VedantSheel08/SmartSolarTracker/FLOW CHART Smart Solar Panel.pdf

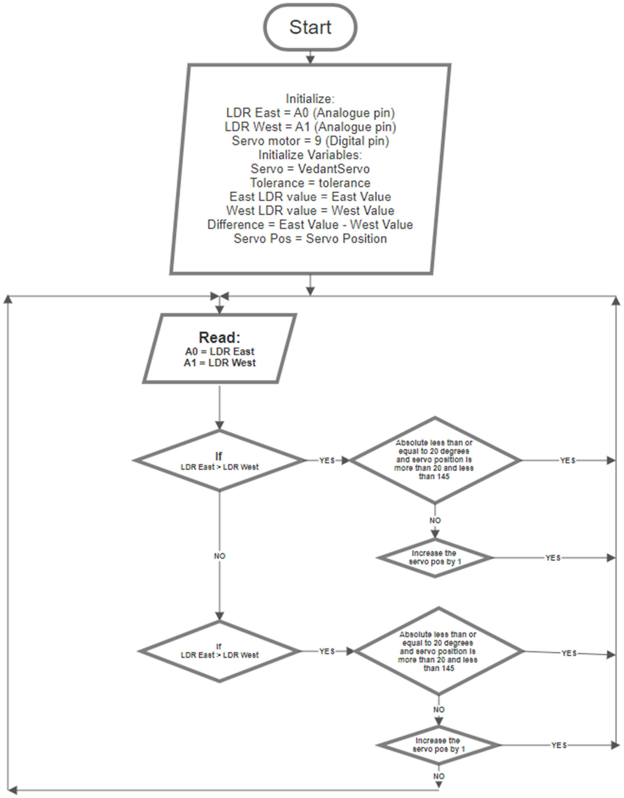
[picture p2: page 1]
