VedantSheel08/SmartSolarTracker/Arduino circut.jpg

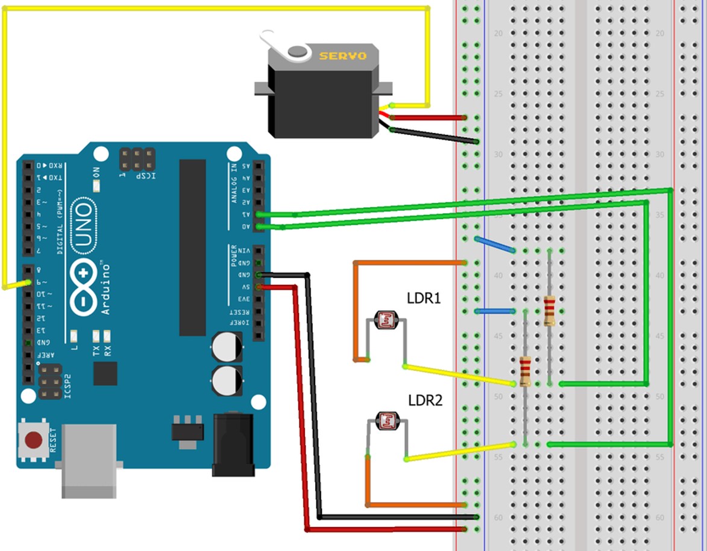
Arduino circut.jpg
