VedantSheel08/SmartSolarTracker/bar graph.jpg

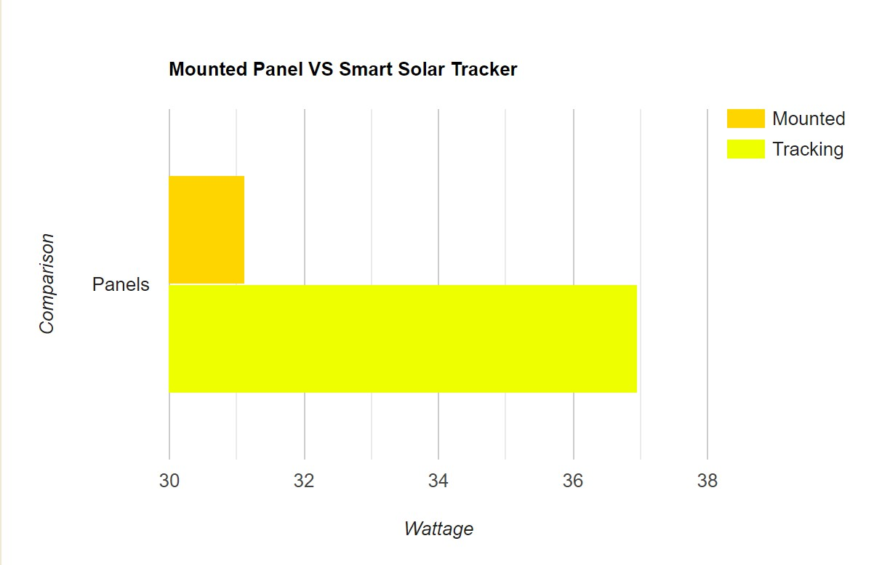
bar graph.jpg
