VedantSheel08/SmartSolarTracker/Screenshot 2022-05-10 175936.jpg

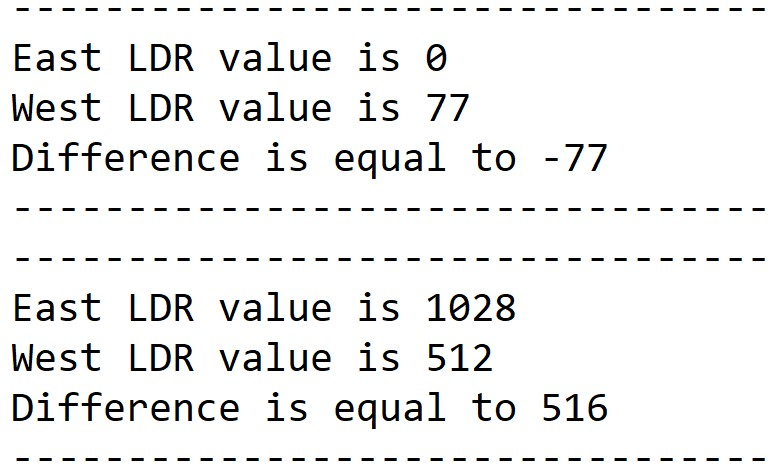
Screenshot 2022-05-10 175936.jpg
